HexabitzPlatform/H1FR1x/README.md

# H1FR1x-Hardware
Hexabitz SX1276 LoRa Module 868 MHz Module Hardware Design
