HexabitzPlatform/H1FR1x/H1FR10/Released/BOM/H1FR10.xlsx

 |  | www.hexabitz.com info@hexabitz.com |  | Bill Of Materials
Customer | Hexabitz | Revision | 0
Project | Hexabitz Modules | Date | 2023-11-15
Board | SX1276 LoRa Module 868 MHz (H1FR10) | Notes
Designator | Description | Manufacturer Part Number | Manufacturer | Octopart Url | Quantity
RESET | Headers & Wire Housings Unshrouded 1 POS T/H | 5-146280-1 | TE Connectivity | https://octopart.com/5-146280-1-te+connectivity+%2F+amp-40259676?r=sp | 1
SWD | Conn Unshrouded Header HDR 3 POS 2.54mm Solder ST Top Entry Thru-Hole Carton | 5-146281-3 | TE Connectivity | https://octopart.com/5-146281-3-te+connectivity+%2F+amp-39745942?r=sp | 1
J1 | RF Connector, 1 Contact(s), Male, Board Mount, Surface Mount Termina | U.FL-R-SMT-1(10) | HIROSE ELECTRIC | https://octopart.com/u.fl-r-smt-1%2810%29-hirose+electric-42409530?r=sp | 1
R1 | RES SMD 0.0OHM JUMPER 1/10W 0603 | RC0603JR-070RL | YAGEO [VR] | https://octopart.com/rc0603jr-070rl-yageo-1241539?r=sp | 1
R2 | Thick Film Resistors - SMD 0603 270 Ohm 5% Tol | ERJ-3GEYJ271V | Panasonic | https://octopart.com/erj-3geyj271v-panasonic-55560546?r=sp | 1
R3 | RES SMD 10K OHM 1% 1/10W 0603 | RC0603FR-0710KL | YAGEO | https://octopart.com/rc0603fr-0710kl-yageo-40025538?r=sp | 1
C1, C2, C4, C6, C8, C9 | CAP CER 0.1 UF 10V 10% X7R 0603 | C0603C104K8RACTU | KEMET | https://octopart.com/c0603c104k8ractu-kemet-145075?r=sp&s=9bS9ASSwSEqMCE9KBEQZ0g | 6
C5 | CAP CER 1 UF 16V X7R 0805 | CC0805KKX7R7BB105 | YAGEO | https://octopart.com/cc0805kkx7r7bb105-yageo-8376555?r=sp | 1
C3, C7 | CAP TANT 4.7 UF 10V 20% 0805 | 10TPU4R7MSI | Panasonic | https://octopart.com/10tpu4r7msi-panasonic-29487748?r=sp | 2
C13 | Tantalum Capacitors - Solid SMD 16V 10uF 10% 1210 ESR= 500 mOhm | TPSB106K016R0500 | KYOCERA AVX | https://octopart.com/tpsb106k016r0500-kyocera+avx-71041120?r=sp | 1
FB1 | Ind chip Bead Multi-Layer 30 ohms 25% 100MHZ Ferrite 1,5A 0603Punched paper T/R | MMZ1608Y300BTA00 | TDK | https://octopart.com/mmz1608y300bta00-tdk-7906990?r=sp | 1
D1 | Red 0603 130° Clear 54 mcd 2 V Surface Mount ChipLED | VLMS1300-GS08 | Vishay | https://octopart.com/vlms1300-gs08-vishay-21709201?r=sp&s=0nXJNjGsSbWwqfqWlZv0EA | 1
U1 | MCU 32-Bit ARM Cortex-M0+ RISC 512kByte Flash 1.7V to 3.6V 48-Pin UFQFPN Tray | STM32G0B1CEU6N | STMicroelectronics | https://octopart.com/stm32g0b1ceu6n-stmicroelectronics-116364672?r=sp | 1
U2 | 868MHz 100mW CE-RED Certified Long Range LoRa Module LoRa1276-C1 | Lora1276-C1-868 | G-NiceRF | https://www.alibaba.com/product-detail/G-NiceRF-LoRa1276-C1-CE-RED_1600875105198.html | 1
X1 | 8,0000MHZ 33pF SMD MURATA Resonators | CSTNE8M00G550000R0 | Murata | https://octopart.com/cstne8m00g550000r0-murata-91406934?r=sp | 1
