HexabitzPlatform/H1FR1x/H1FR10/Documentation/H1FR10.pdf

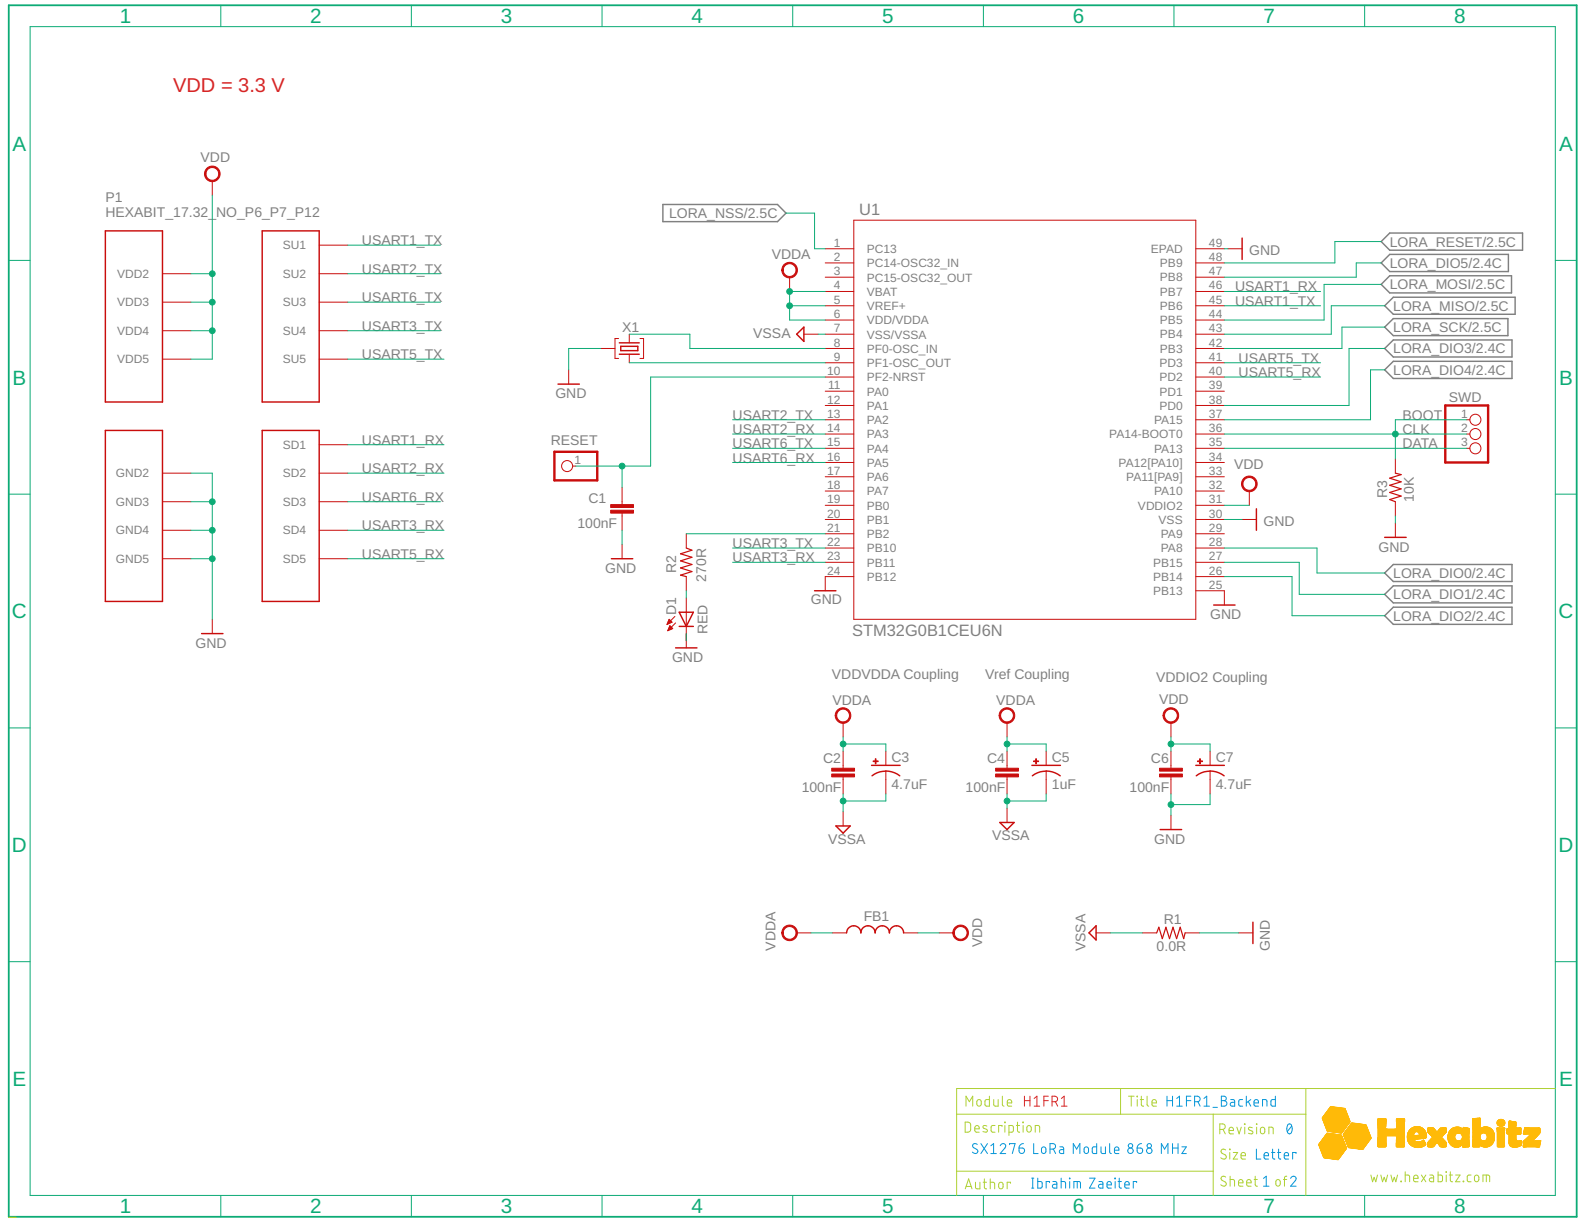
[picture p1: page 1]

5 | 45 PB7 USART1_TX
6 | 44 PB6

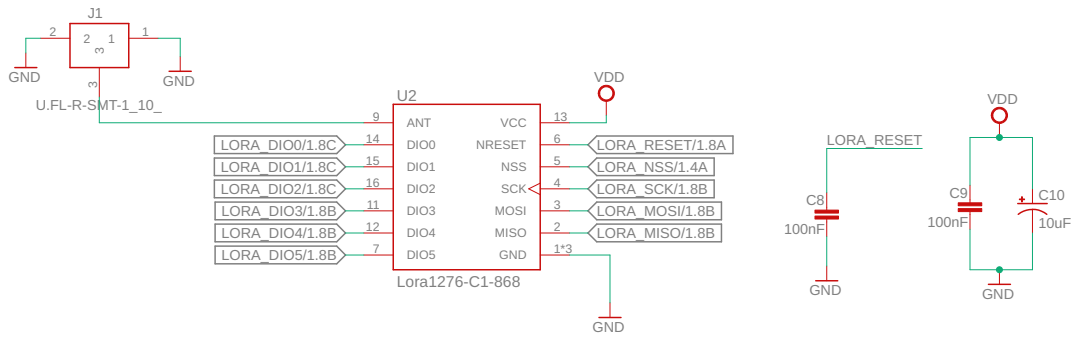
[picture p2: page 2]
