HexabitzPlatform/H1FR1x/H1FR10/Design/H1FR10.brd

## EAGLE design H1FR10/Design/H1FR10.brd (2023-11-16)

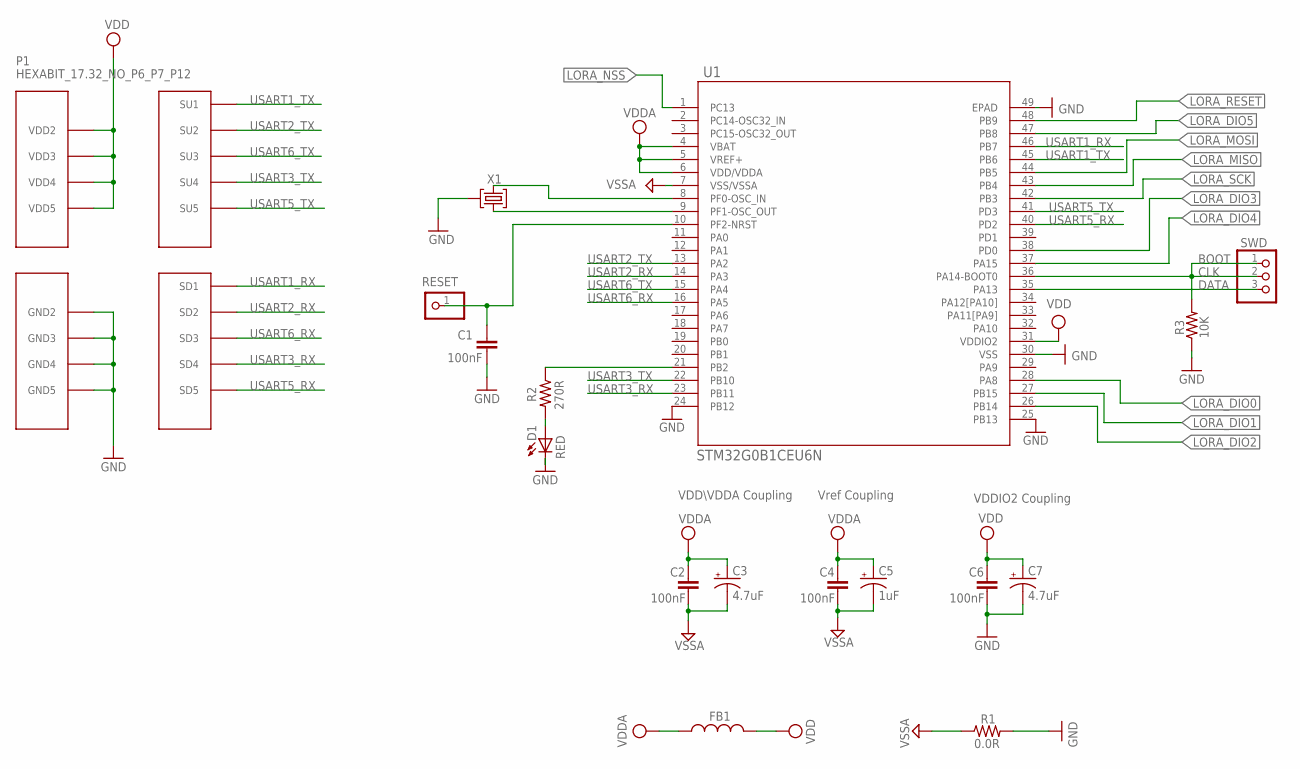
[picture p3: schematic H1FR10.sch, sheet 1]

Parts:
C1, C2, C4, C6: 100nF; C-0603
C3, C7: 4.7uF; C-0805-POL
C5: 1uF; C-0805-POL
D1: RED; VLMS1300-GS08; MPN VLMS1300-GS08
FB1: FB-0603
P1: HEXABIT_17.32_NO_P6_P7_P12
R1: 0.0R; R-0603
R2: 270R; R-0603
R3: 10K; R-0603
RESET: R; 1X01
SWD: PINHD-1X3SWD; SWD
U1: STM32G0B1CEU6N; HEXABITZ_ICS_QFN_B1CEU6_STM-L
X1: XTALL_CSTCE8M00G52

Connections:
CLK: R3.2, SWD.1, SWD.2, U1.36 (PA14-BOOT0)
DATA: SWD.3, U1.35 (PA13)
GND: C1.2, C6.2, C7.2 (-), D1.C, P1.PAD_PD8 (GND2), P1.PAD_PD9 (GND3), P1.PAD_PD10 (GND4), P1.PAD_PD11 (GND5), R1.2, R3.1, U1.24 (PB12), U1.25 (PB13), U1.30 (VSS), U1.49 (EPAD), X1.P$2 (2); also elsewhere on the board
LORA_DIO0: U1.28 (PA8); also elsewhere on the board
LORA_DIO1: U1.27 (PB15); also elsewhere on the board
LORA_DIO2: U1.26 (PB14); also elsewhere on the board
LORA_DIO3: U1.38 (PD0); also elsewhere on the board
LORA_DIO4: U1.37 (PA15); also elsewhere on the board
LORA_DIO5: U1.47 (PB8); also elsewhere on the board
LORA_MISO: U1.43 (PB4); also elsewhere on the board
LORA_MOSI: U1.44 (PB5); also elsewhere on the board
LORA_NSS: U1.1 (PC13); also elsewhere on the board
LORA_RESET: U1.48 (PB9); also elsewhere on the board
LORA_SCK: U1.42 (PB3); also elsewhere on the board
unnamed: D1.A, R2.2
unnamed: R2.1, U1.21 (PB2)
unnamed: U1.9 (PF1-OSC_OUT), X1.P$1 (1)
unnamed: U1.8 (PF0-OSC_IN), X1.P$3 (3)
unnamed: C1.1, RESET.1, U1.10 (PF2-NRST)
USART1_RX: P1.PAD_PD1 (SD1), U1.46 (PB7)
USART1_TX: P1.PAD_PU1 (SU1), U1.45 (PB6)
USART2_RX: P1.PAD_PD2 (SD2), U1.14 (PA3)
USART2_TX: P1.PAD_PU2 (SU2), U1.13 (PA2)
USART3_RX: P1.PAD_PD4 (SD4), U1.23 (PB11)
USART3_TX: P1.PAD_PU4 (SU4), U1.22 (PB10)
USART5_RX: P1.PAD_PD5 (SD5), U1.40 (PD2)
USART5_TX: P1.PAD_PU5 (SU5), U1.41 (PD3)
USART6_RX: P1.PAD_PD3 (SD3), U1.16 (PA5)
USART6_TX: P1.PAD_PU3 (SU3), U1.15 (PA4)
VDD: C6.1, C7.1 (+), FB1.2, P1.PAD_PU8 (VDD2), P1.PAD_PU9 (VDD3), P1.PAD_PU10 (VDD4), P1.PAD_PU11 (VDD5), U1.31 (VDDIO2); also elsewhere on the board
VDDA: C2.1, C3.1 (+), C4.1, C5.1 (+), FB1.1, U1.4 (VBAT), U1.5 (VREF+), U1.6 (VDD/VDDA)
VSSA: C2.2, C3.2 (-), C4.2, C5.2 (-), R1.1, U1.7 (VSS/VSSA)

Notes on the sheet:
Vref Coupling
VDDIO2 Coupling
VDD\VDDA Coupling
BOOT

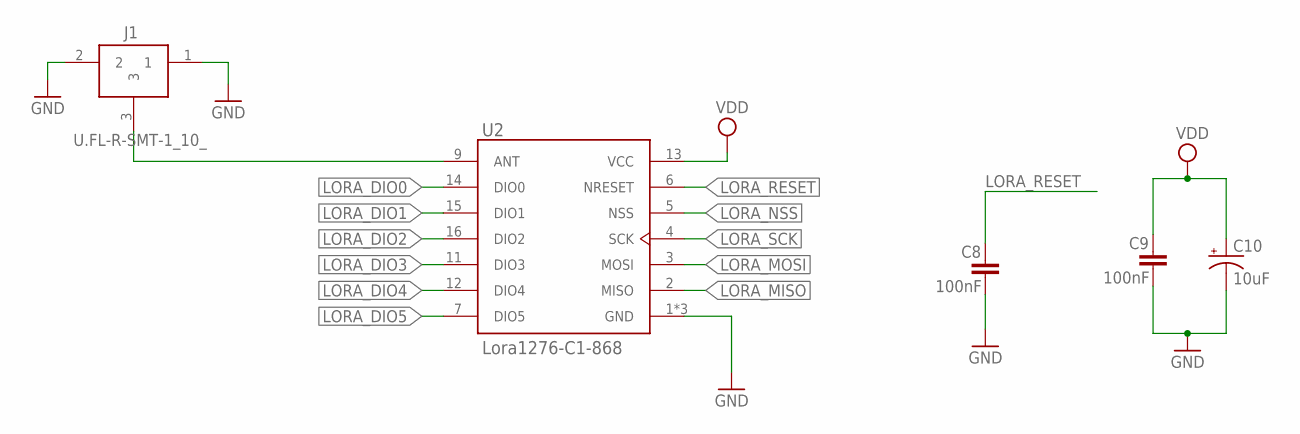
[picture p4: schematic H1FR10.sch, sheet 2]

Parts:
C8, C9: 100nF; C-0603
C10: 10uF; C-1210-POL
J1: U.FL-R-SMT-1_10_; U.FL-R-SMT-1(10)
U2: Lora1276-C1-868; LORA127X-C1

Connections:
GND: C8.2, C9.2, C10.2 (-), J1.1, J1.2, U2.1 (GND), U2.8 (GND), U2.10 (GND); also elsewhere on the board
LORA_DIO0: U2.14 (DIO0); also elsewhere on the board
LORA_DIO1: U2.15 (DIO1); also elsewhere on the board
LORA_DIO2: U2.16 (DIO2); also elsewhere on the board
LORA_DIO3: U2.11 (DIO3); also elsewhere on the board
LORA_DIO4: U2.12 (DIO4); also elsewhere on the board
LORA_DIO5: U2.7 (DIO5); also elsewhere on the board
LORA_MISO: U2.2 (MISO); also elsewhere on the board
LORA_MOSI: U2.3 (MOSI); also elsewhere on the board
LORA_NSS: U2.5 (NSS); also elsewhere on the board
LORA_RESET: C8.1, U2.6 (NRESET); also elsewhere on the board
LORA_SCK: U2.4 (SCK); also elsewhere on the board
unnamed: J1.3, U2.9 (ANT)
VDD: C9.1, C10.1 (+), U2.13 (VCC); also elsewhere on the board

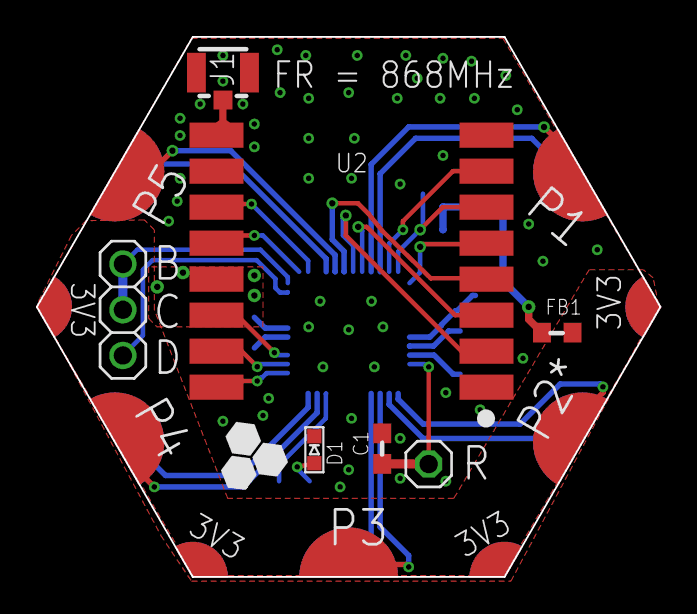
[picture p5: board H1FR10.brd from above]

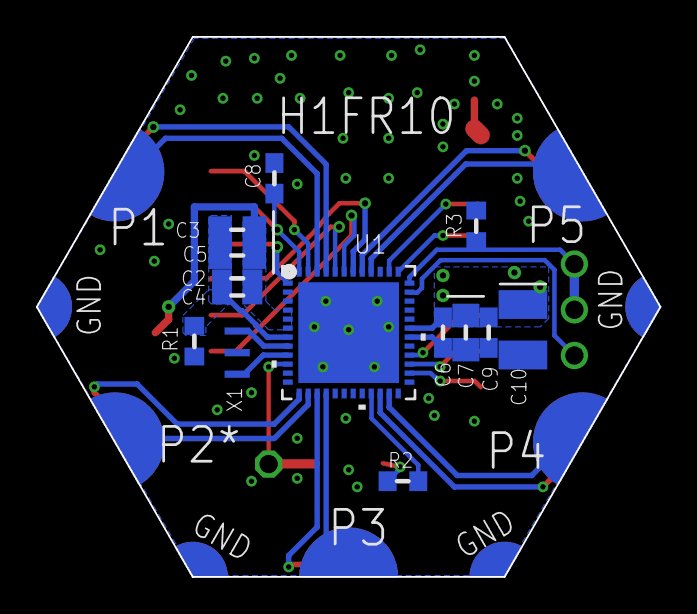
[picture p6: board H1FR10.brd from below]

Board: 2 copper layers, 34.6 x 30.0 mm, 22 parts (14 on the bottom side), 33 nets.
