HexabitzPlatform/H1FR1x/(commit log)

2023-11-15 -The first version is done
    [H1FR10.brd, H1FR10.sch, H1FR10.xlsx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]
2023-11-15 -Correct some documentaion issues
    [H1FR10.brd, H1FR10.sch]
2023-11-16 -Fix clearance error
    [H1FR10.brd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]
